yxdu2100/DIBS_Audio/enclosure/out/base_C_d10_h0.8.step

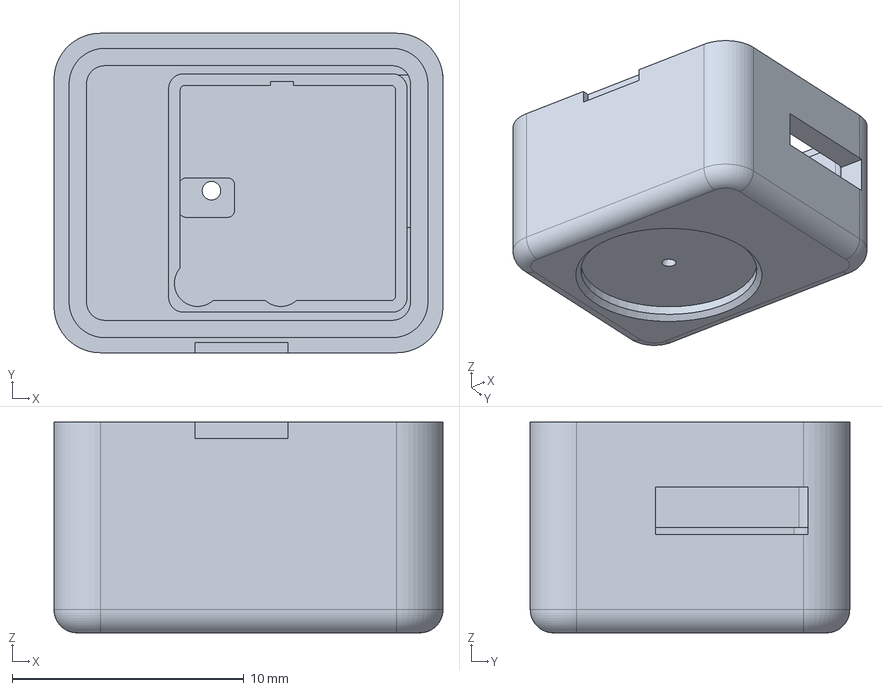
[picture p1: CAD file, 2026-11-10, last stored version]
enclosure/out/base_C_d10_h0.8.step
16.8 x 13.8 x 9.10 mm
