yxdu2100/DIBS_Audio/enclosure/out_side_v2/base_B_d8_h1.0.step

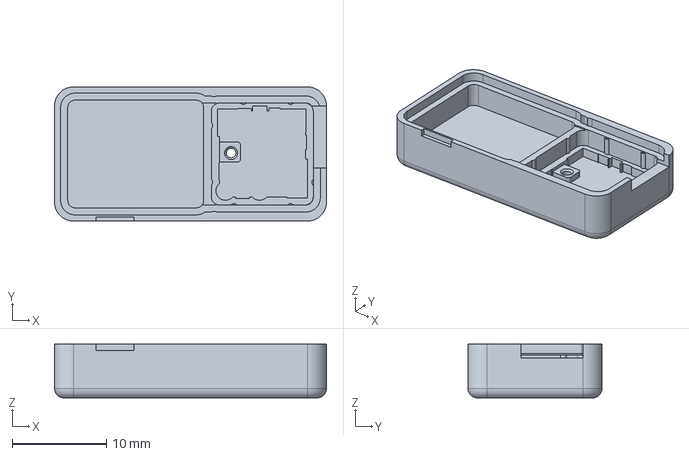
[picture p3: CAD file, 2026-11-10, last stored version]
enclosure/out_side_v2/base_B_d8_h1.0.step
28.8 x 14.2 x 5.70 mm
