yxdu2100/DIBS_Audio/enclosure/out_stacked_v3/base_C_d10_h0.8.step

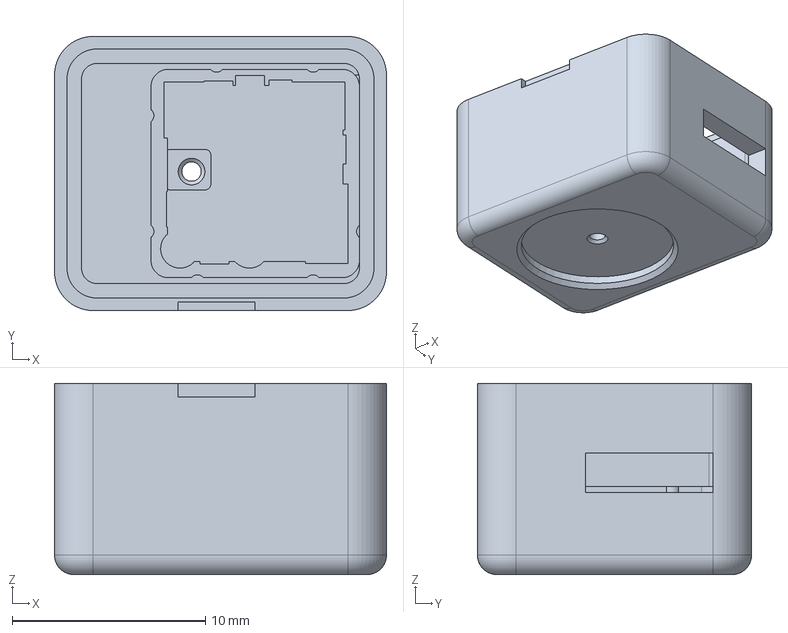
[picture p4: CAD file, 2026-11-10, last stored version]
enclosure/out_stacked_v3/base_C_d10_h0.8.step
17.2 x 14.2 x 9.90 mm
