yxdu2100/DIBS_Audio/enclosure/out/lid.step

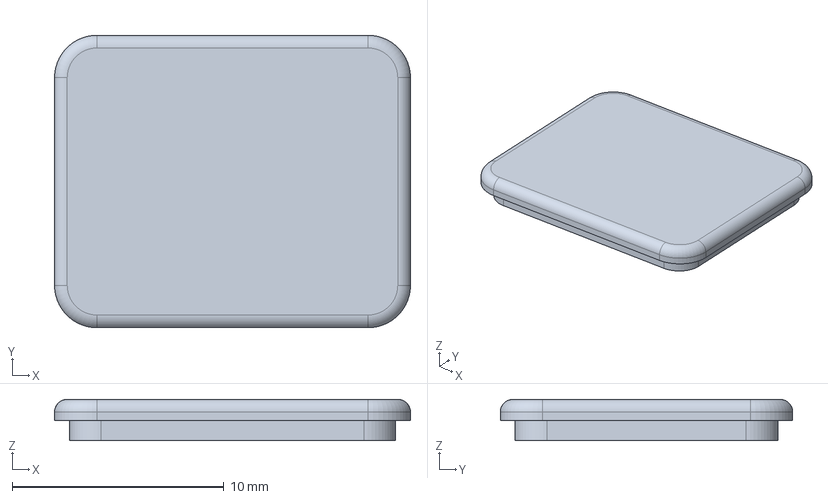
[picture p5: CAD file, 2026-11-10, last stored version]
enclosure/out/lid.step
16.8 x 13.8 x 1.95 mm
