yxdu2100/DIBS_Audio/enclosure/out_side_v2/gasket_template.step

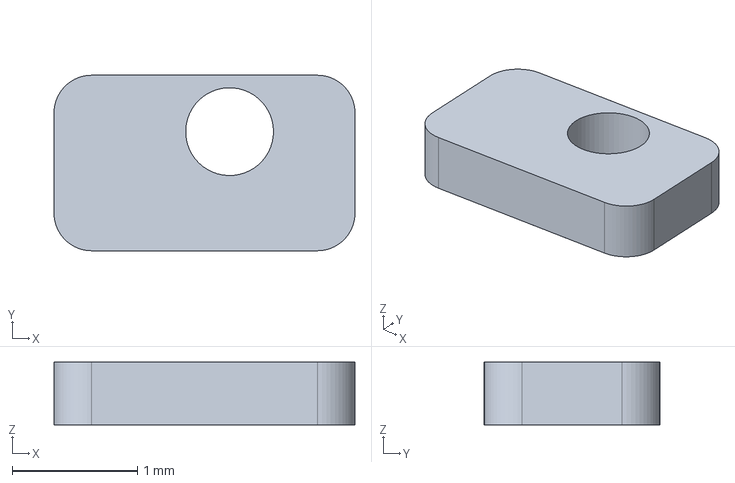
[picture p6: CAD file, 2026-11-10, last stored version]
enclosure/out_side_v2/gasket_template.step
2.40 x 1.40 x 0.5 mm
