yxdu2100/DIBS_Audio/enclosure/out/gasket_template.step

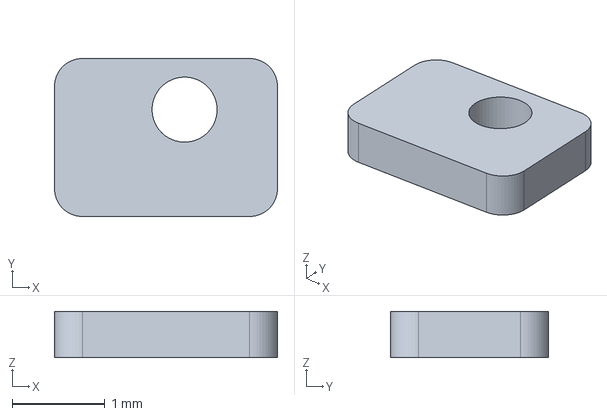
[picture p7: CAD file, 2026-11-10, last stored version]
enclosure/out/gasket_template.step
2.40 x 1.70 x 0.5 mm
