yxdu2100/DIBS_Audio/enclosure/out_coupon/lid_20.stl

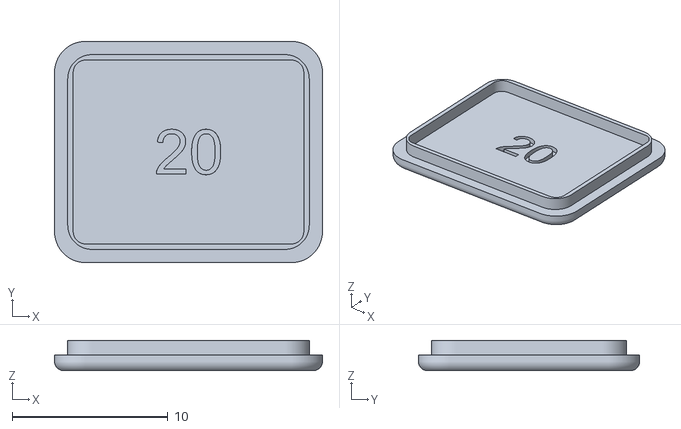
[picture p8: CAD file, 2026-11-10, last stored version]
enclosure/out_coupon/lid_20.stl
17.2 x 14.2 x 1.95
