yxdu2100/DIBS_Audio/enclosure/out_side_v2/lid.step

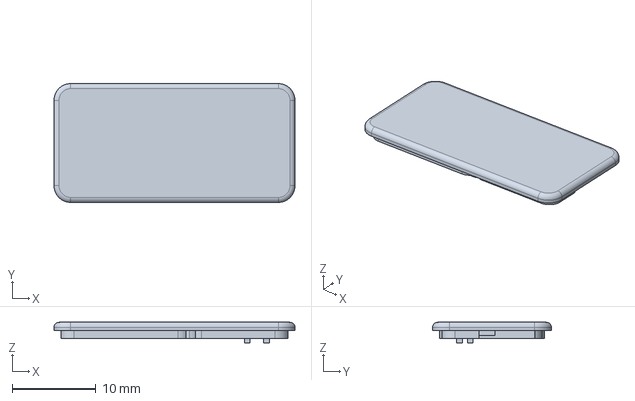
[picture p9: CAD file, 2026-11-10, last stored version]
enclosure/out_side_v2/lid.step
28.8 x 14.2 x 2.45 mm
