yxdu2100/DIBS_Audio/enclosure/out_stacked_v3/plate.step

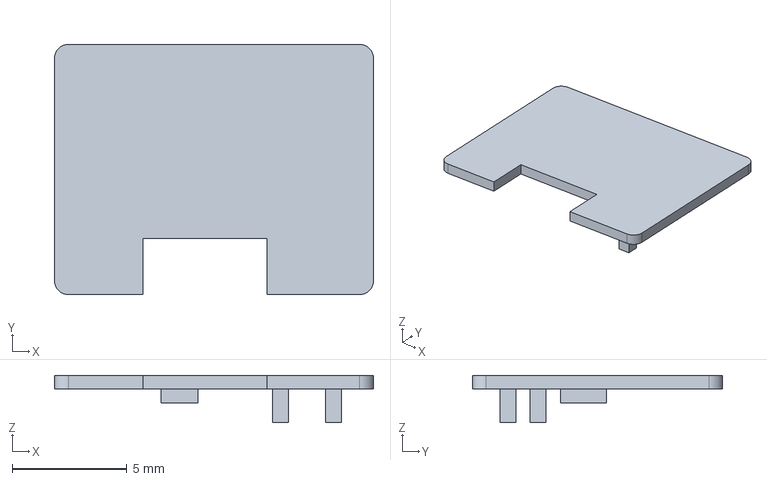
[picture p10: CAD file, 2026-11-10, last stored version]
enclosure/out_stacked_v3/plate.step
13.9 x 10.9 x 2.05 mm
