yxdu2100/DIBS_Audio/enclosure/out/plate.step

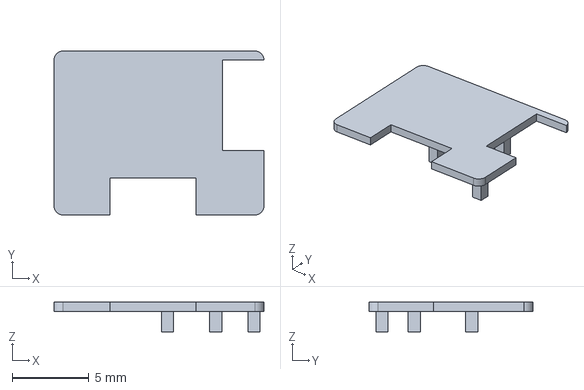
[picture p11: CAD file, 2026-11-10, last stored version]
enclosure/out/plate.step
13.7 x 10.7 x 1.95 mm
