yxdu2100/DIBS_Audio/enclosure/out_coupon/pcb_frames.stl

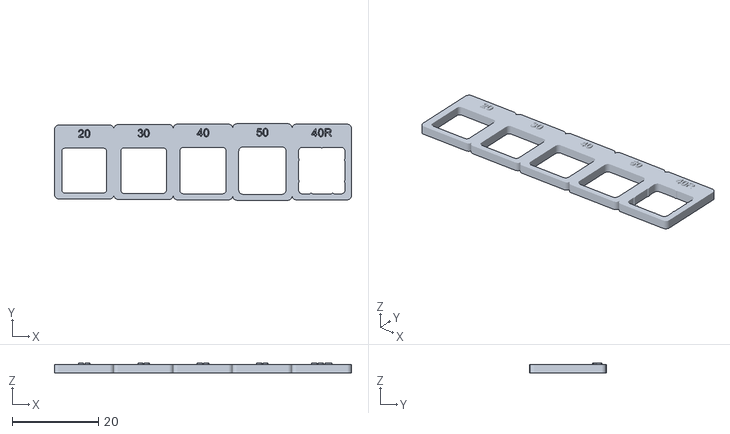
[picture p12: CAD file, 2026-11-10, last stored version]
enclosure/out_coupon/pcb_frames.stl
69.0 x 17.8 x 2.40
