yxdu2100/DIBS_Audio/enclosure/out_coupon/lid_frame.stl

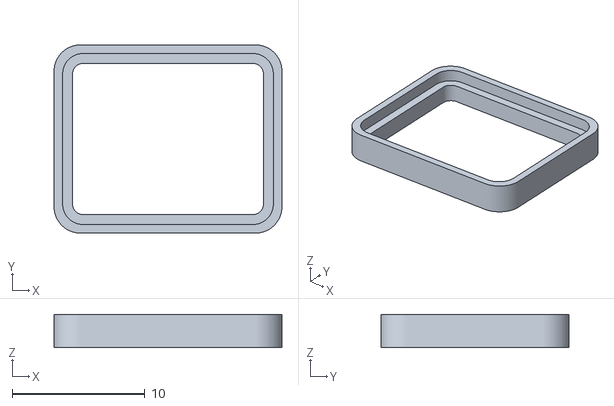
[picture p13: CAD file, 2026-11-10, last stored version]
enclosure/out_coupon/lid_frame.stl
17.2 x 14.2 x 2.50
