yxdu2100/DIBS_Audio/enclosure/out_coupon/holes.stl

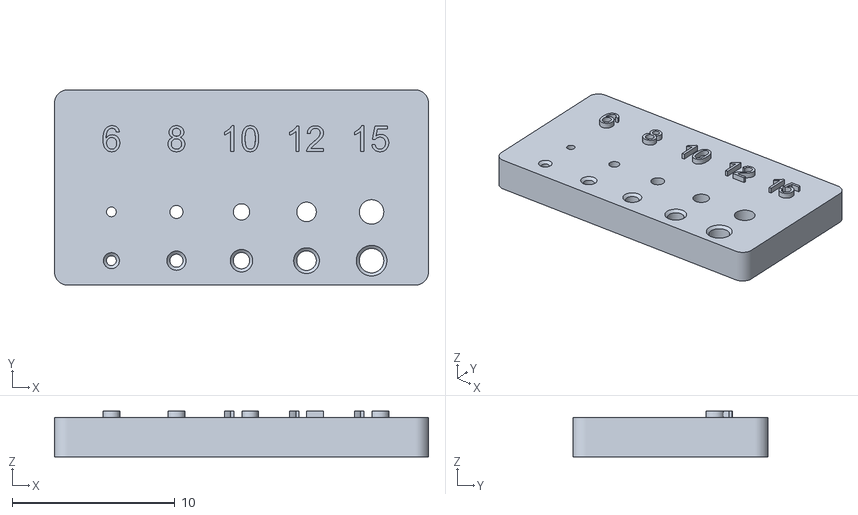
[picture p14: CAD file, 2026-11-10, last stored version]
enclosure/out_coupon/holes.stl
23.0 x 12.0 x 2.80
