yxdu2100/DIBS_Audio/(list of files, cad)

Other CAD files:
enclosure/out_coupon/lid_15.stl
enclosure/out_stacked_v3/base_B_d8_h1.0.step
enclosure/out_stacked_v3/lid.step
enclosure/out/base_A_d6_h1.0.step
enclosure/out_coupon/lid_10.stl
enclosure/out_side_v2/base_A_d6_h1.0.step
enclosure/out_side_v2/base_C_d10_h0.8.step
enclosure/out/base_B_d8_h1.0.step
enclosure/out_stacked_v3/base_A_d6_h1.0.step
enclosure/out/base_A_d6_h1.0.stl
enclosure/out/base_B_d8_h1.0.stl
enclosure/out/base_C_d10_h0.8.stl
enclosure/out/gasket_template.stl
enclosure/out/lid.stl
enclosure/out/plate.stl
enclosure/out_side_v1/base_A_d6_h1.0.step
enclosure/out_side_v1/base_A_d6_h1.0.stl
enclosure/out_side_v1/base_B_d8_h1.0.step
enclosure/out_side_v1/base_B_d8_h1.0.stl
enclosure/out_side_v1/base_C_d10_h0.8.step
enclosure/out_side_v1/base_C_d10_h0.8.stl
enclosure/out_side_v1/gasket_template.step
enclosure/out_side_v1/gasket_template.stl
enclosure/out_side_v1/lid.step
enclosure/out_side_v1/lid.stl
enclosure/out_side_v2/base_A_d6_h1.0.stl
enclosure/out_side_v2/base_B_d8_h1.0.stl
enclosure/out_side_v2/base_C_d10_h0.8.stl
enclosure/out_side_v2/gasket_template.stl
enclosure/out_side_v2/lid.stl
enclosure/out_side_v2/print/base_A_d6_h1.0.stl
enclosure/out_side_v2/print/base_B_d8_h1.0.stl
enclosure/out_side_v2/print/base_C_d10_h0.8.stl
enclosure/out_side_v2/print/lid.stl
enclosure/out_stacked_v2/base_A_d6_h1.0.step
enclosure/out_stacked_v2/base_A_d6_h1.0.stl
enclosure/out_stacked_v2/base_B_d8_h1.0.step
enclosure/out_stacked_v2/base_B_d8_h1.0.stl
enclosure/out_stacked_v2/base_C_d10_h0.8.step
enclosure/out_stacked_v2/base_C_d10_h0.8.stl
enclosure/out_stacked_v2/gasket_template.step
enclosure/out_stacked_v2/gasket_template.stl
enclosure/out_stacked_v2/lid.step
enclosure/out_stacked_v2/lid.stl
enclosure/out_stacked_v2/plate.step
enclosure/out_stacked_v2/plate.stl
enclosure/out_stacked_v3/base_A_d6_h1.0.stl
enclosure/out_stacked_v3/base_B_d8_h1.0.stl
enclosure/out_stacked_v3/base_C_d10_h0.8.stl
enclosure/out_stacked_v3/gasket_template.stl
enclosure/out_stacked_v3/lid.stl
enclosure/out_stacked_v3/plate.stl
enclosure/out_stacked_v3/print/base_A_d6_h1.0.stl
enclosure/out_stacked_v3/print/base_B_d8_h1.0.stl
enclosure/out_stacked_v3/print/base_C_d10_h0.8.stl
enclosure/out_stacked_v3/print/lid.stl
enclosure/out_stacked_v3/print/plate.stl
