yxdu2100/DIBS_Audio/firmware/src/session.h

#ifndef DIBS_SESSION_H_
#define DIBS_SESSION_H_

#include <stdint.h>

/* A session records audio and IMU together until stopped (see protocol.h). */
void session_init(uint32_t reset_reason);
void session_start(void);
void session_stop(uint8_t end_reason);

#endif /* DIBS_SESSION_H_ */
