yxdu2100/DIBS_Audio/(commit log)

2026-11-10 DIBS: board, data-collection firmware, iOS app and tools
    - boards/dibs: Zephyr board for the nRF52832-CIAA DIBS board (LDO only,
    32 kHz crystal, RTT console, IMU INT1 on GPIO SENSE, APPROTECT kept open)
    - firmware: BLE protocol v3 sessions recording PDM audio (IMA ADPCM) and
    LSM6DSV32X IMU at 120 Hz with session-clock anchors for alignment; battery
    and charger reporting; motion-based parking; task watchdog
    - app/DIBS_AUDIO: iOS app recording sessions to WAV + CSV folders, aligning
    IMU to audio, playback, export
    - samples: bring-up test and sleep-floor current test
    - tools: flash + RTT script, Mac BLE test harness, tap alignment check
    - enclosure: enclosure generator scripts and outpu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
    [base_A_d6_h1.0.step, base_A_d6_h1.0.stl, base_B_d8_h1.0.step, base_B_d8_h1.0.stl, base_C_d10_h0.8.step, base_C_d10_h0.8.stl, gasket_template.step, gasket_template.stl]
2026-11-10 Choose between several boards
    Firmware advertises a unique DIBS-XXXX name from the FICR device ID. The app
    lists nearby boards in a Choose Board sheet, remembers the selected one and
    reconnects to it (retrievePeripherals, pending connect), records the board
    name in session.json, and only ever connects to the chosen board. The Mac
    test harness selects a board by name or the first one found.
    Built, not yet tested on hardware.
2026-11-10 Advertise as DIBS_Audio-XXXX; stop tracking enclosure and .vscode
    The board name now says which DIBS device it is. Enclosure design files and
    editor settings stay local (ignored); the README explains the VS Code board
    root setting instead.
    [base_A_d6_h1.0.step, base_A_d6_h1.0.stl, base_B_d8_h1.0.step, base_B_d8_h1.0.stl, base_C_d10_h0.8.step, base_C_d10_h0.8.stl, gasket_template.step, gasket_template.stl]
2026-11-10 Low-battery protection and shutdown for storage
    Firmware checks the cell on battery (5 s while connected, else 60 s; three
    readings decide): below 3.30 V it stops the session and refuses new ones,
    below 3.15 V it puts the BQ25180 in shutdown mode (15 nA, USB wakes). BLE
    command 0x02 requests shutdown mode, deferred until USB is removed when
    present. The app shows "Battery low" / "Turns off when unplugged", refuses
    to start on a low battery and offers "Turn off for storage".
